ttakao/raspi-mobile/case/ssh_case_v4_notes.txt

ケースV4 試作
内寸90x90x33mm、壁/表板/裏蓋2mm、外寸94x94x37mm（組立時）。外周角R3。
正面から見て左右x、下から上y、前から後ろz。
2026-10-14：ユーザーのSTL確認により、本体の窓とスイッチを元のV4から左右反転。
モデル座標の液晶外形位置x4.5,y35、窓x11.5,y38、寸法75x50mm。左右の被せはモデルx小側7mm、大側3mm。上下3mm。
表示領域74.5mmに対し窓幅75mm。右の非表示部7.5mmのうち0.5mmは窓内に残る。
上側左右にM3ネジ穴径3.4mm、蓋側六角ナット受け対辺5.8mm。
下側ネジ受け撤去。差込爪2個、幅10/厚2、受け幅10.8/高さ2.4（試験の0.4mm仕様）。
下側受けはケース内側へ7mm突出、裏蓋直前の位置。下側に固定用形状が全くない構造ではない。
スイッチ穴4.8mm：モデルx=0側面（元のV4と反対側）、外形上端から20mm、前面から18mmの中心位置。
スイッチ内突き出し14mmと機器・電池の干渉は実物で確認する。部品の正確な立体位置は未提供。

印刷：STLの保存方向で100%。本体は窓側をベッド、蓋は外面をベッド。
本体の下側受けと蓋の爪・ナット受けの下には浮いた部分がある。試験片とは異なりサポートを要する。
PrusaSlicerのサポートペイントで必要箇所のみ指定し、差込穴内部へのサポートは可能な限り避ける。
材料/積層/温度は試験片と同じ条件を使う。爪の下面のサポート跡は除去してから組む。
最初に蓋の下端の爪を差し込み、上端を閉じる。無理に曲げず、閉じなければ修正する。
形状の閉鎖性・単一連結・閉じた位置での本体と蓋の重複ゼロを計算確認済み。
印刷性・斜め挿入の動作・機器との干渉・強度は実機未検証。

蓋STLは左右修正時に変更していない。build_case.py --body-onlyで本体のみ再生成できる。
