ttakao/raspi-mobile/case/ssh_case_v4_body.stl

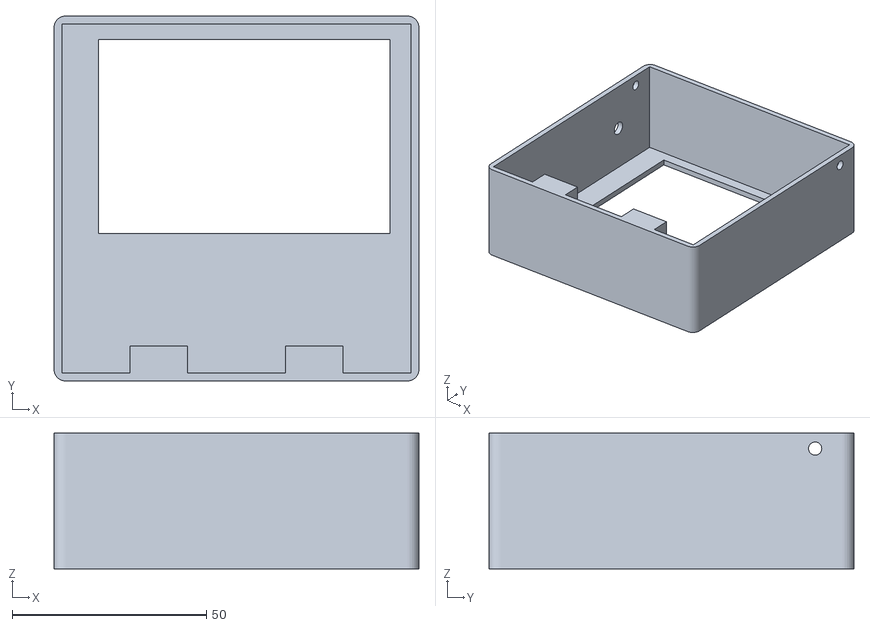
[picture p1: CAD file, 2026-10-14]
case/ssh_case_v4_body.stl
94.0 x 94.0 x 35.0
