ttakao/raspi-mobile/case/ssh_case_v4_lid.stl

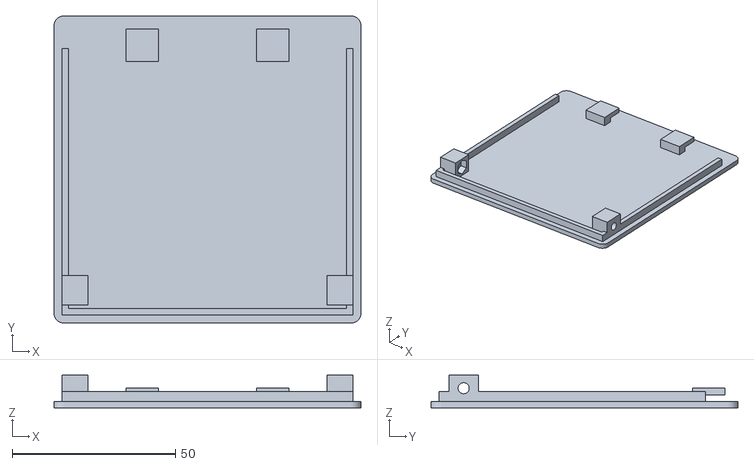
[picture p2: CAD file, 2026-10-14]
case/ssh_case_v4_lid.stl
94.0 x 94.0 x 10.0
